supratimdas/GSM-Control/README.md

GSM-Control
===========

SIM300 and ATMEGA32 based remote home automation control system, with usb support for reprogrammability
gsm usb commandline: Console based C code for reprogramming the device
GSMControlUSB: JAVA Swing based GUI for reprogramming the device
gsm_control_with_usb: The firmware code
