supratimdas/GSM-Control/gsm_control_with_usb/gsm_control_pcb.BMP

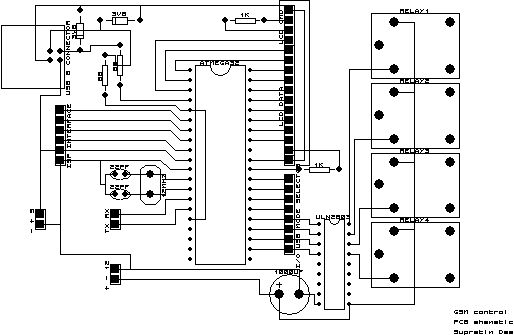
gsm_control_with_usb/gsm_control_pcb.BMP
