supratimdas/GSM-Control/gsm_control_with_usb/gsm_control_pcb - CADCAM Bottom Solder Resist.TXT

G04 PROTEUS RS274X GERBER FILE*
%FSLAX24Y24*%
%MOIN*%
%ADD13C,0.0700*%
%ADD18R,0.1000X0.1000*%
%ADD19C,0.0900*%
%ADD16C,0.1000*%
%ADD14C,0.0800*%
%ADD70C,0.1300*%
G54D13*
X-3000Y+9500D03*
X-3000Y+8500D03*
X-3000Y+7500D03*
X-3000Y+6500D03*
X-3000Y+5500D03*
X-3000Y+4500D03*
X-3000Y+3500D03*
X-3000Y+2500D03*
X-3000Y+1500D03*
X-3000Y+500D03*
X-3000Y-500D03*
X-3000Y-1500D03*
X-3000Y-2500D03*
X-3000Y-3500D03*
X-3000Y-4500D03*
X-3000Y-5500D03*
X-3000Y-6500D03*
X-3000Y-7500D03*
X-3000Y-8500D03*
X-3000Y-9500D03*
X+3000Y-9500D03*
X+3000Y-8500D03*
X+3000Y-7500D03*
X+3000Y-6500D03*
X+3000Y-5500D03*
X+3000Y-4500D03*
X+3000Y-3500D03*
X+3000Y-2500D03*
X+3000Y-1500D03*
X+3000Y-500D03*
X+3000Y+500D03*
X+3000Y+1500D03*
X+3000Y+2500D03*
X+3000Y+3500D03*
X+3000Y+4500D03*
X+3000Y+5500D03*
X+3000Y+6500D03*
X+3000Y+7500D03*
X+3000Y+8500D03*
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
