supratimdas/GSM-Control/ExpressPCB.pdf

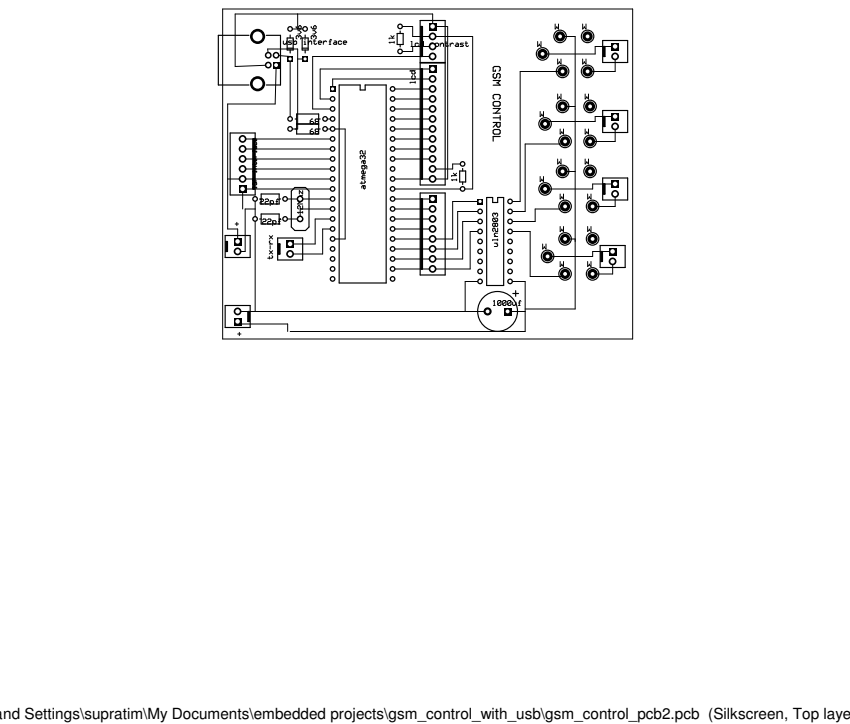
[picture p37: page 1]

and Settings\supratim\My Documents\embedded projects\gsm_control_with_usb\gsm_control_pcb2.pcb (Silkscreen, Top layer
