supratimdas/GSM-Control/ExpressSCH.pdf

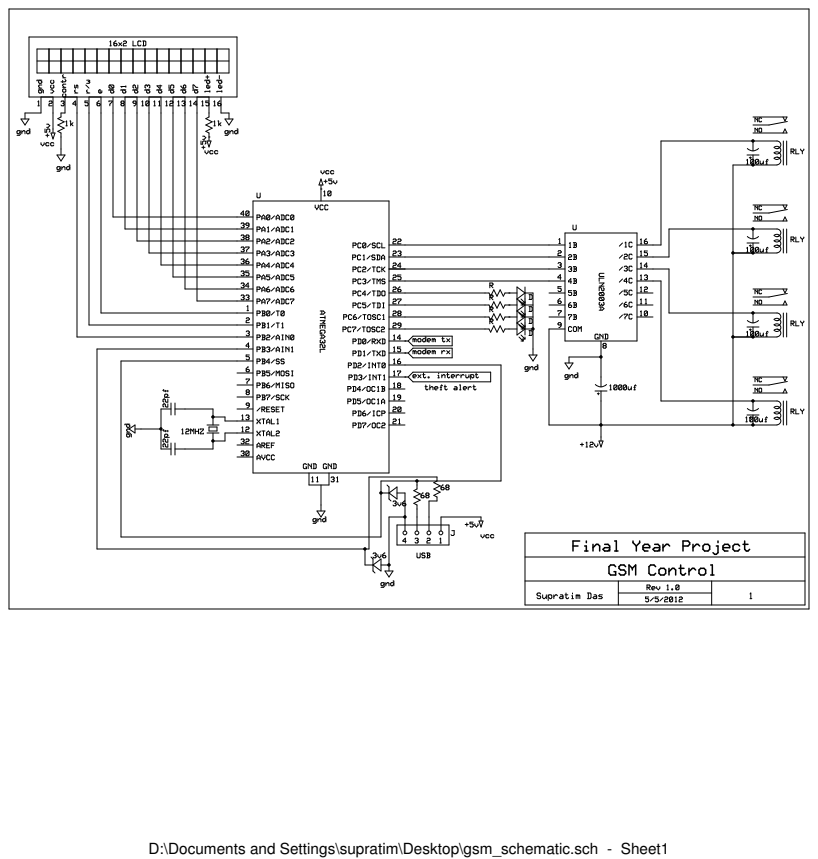
[picture p38: page 1]

D:\Documents and Settings\supratim\Desktop\gsm_schematic.sch - Sheet1
