supratimdas/GSM-Control/(list of files, drawings)

Other design files:
gsm_control_with_usb/gsm_control_pcb2.pcb
gsm_control_with_usb/gsm_control_pcb.LYT
gsm_control_with_usb/gsm_control_schema_simul.DSN
